momu-m/HydroMate-ESP32/3_Schaltplan_und_Diagramme/Diagramm1_Architektur.png

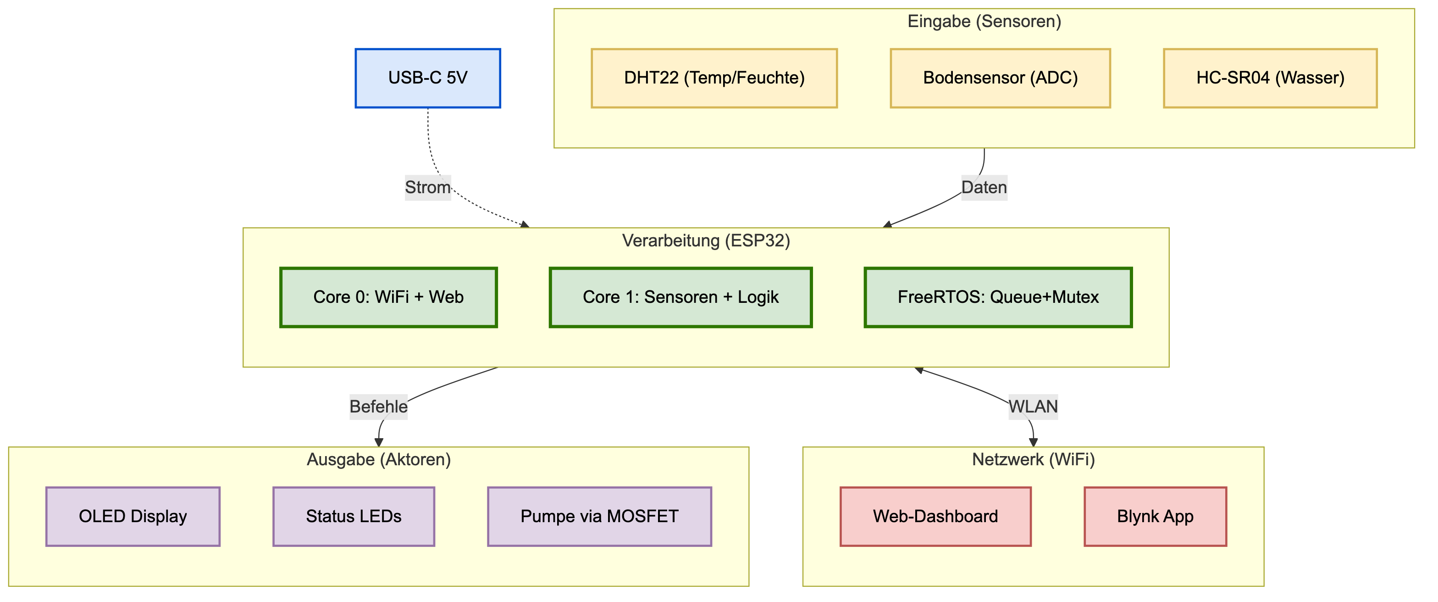
3_Schaltplan_und_Diagramme/Diagramm1_Architektur.png
