momu-m/HydroMate-ESP32/3_Schaltplan_und_Diagramme/Diagramm2_Schaltung.png

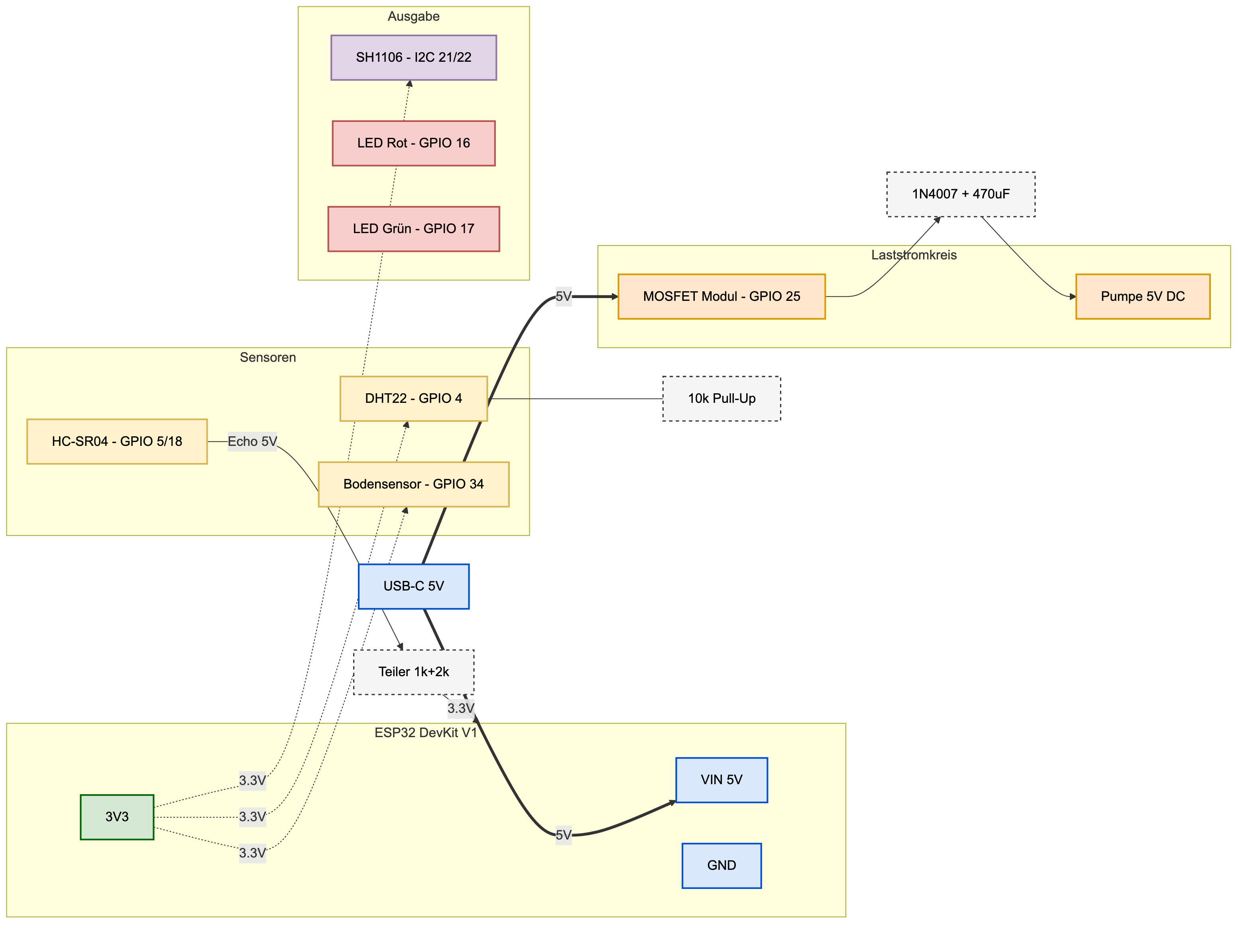
3_Schaltplan_und_Diagramme/Diagramm2_Schaltung.png
