momu-m/HydroMate-ESP32/3_Schaltplan_und_Diagramme/Diagramm3_FreeRTOS.png

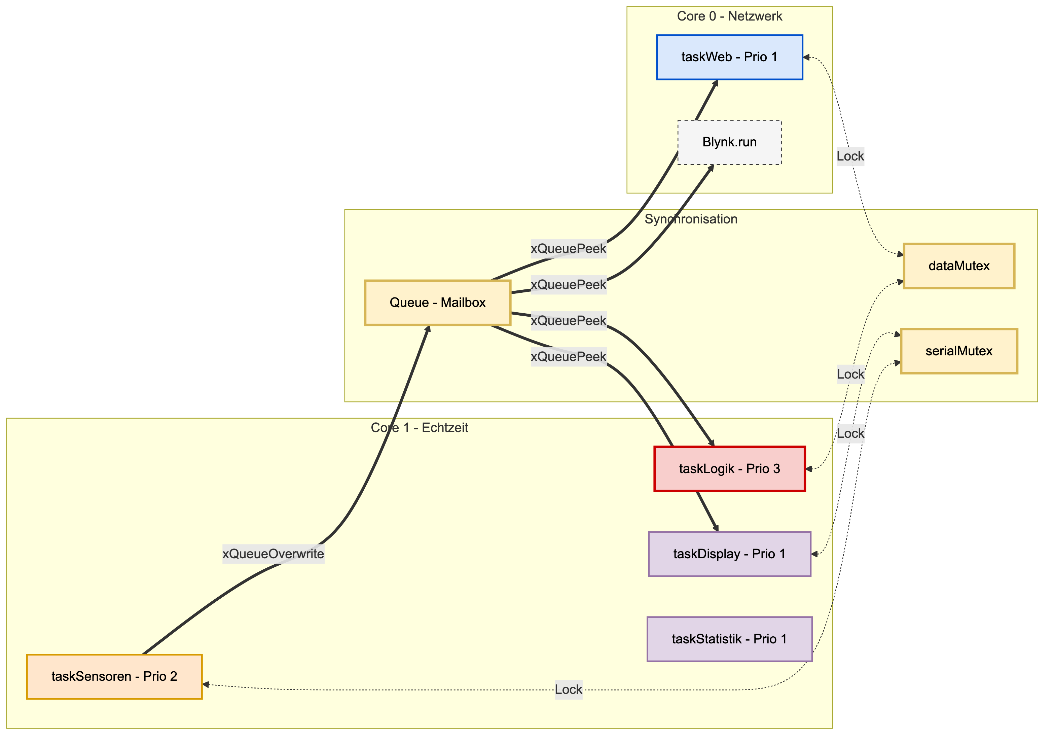
3_Schaltplan_und_Diagramme/Diagramm3_FreeRTOS.png
