momu-m/HydroMate-ESP32/3_Schaltplan_und_Diagramme/Diagramm4_MooreAutomat.png

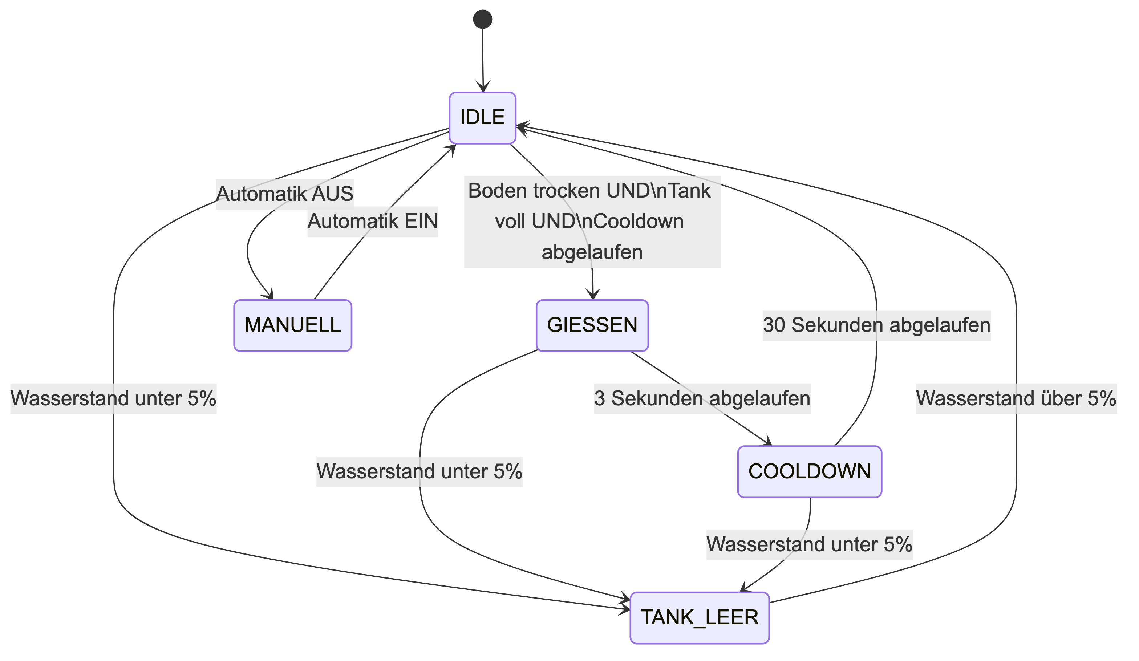
3_Schaltplan_und_Diagramme/Diagramm4_MooreAutomat.png
