momu-m/HydroMate-ESP32/3_Schaltplan_und_Diagramme/Diagramm_1_Systemarchitektur_KORRIGIERT_pro.png

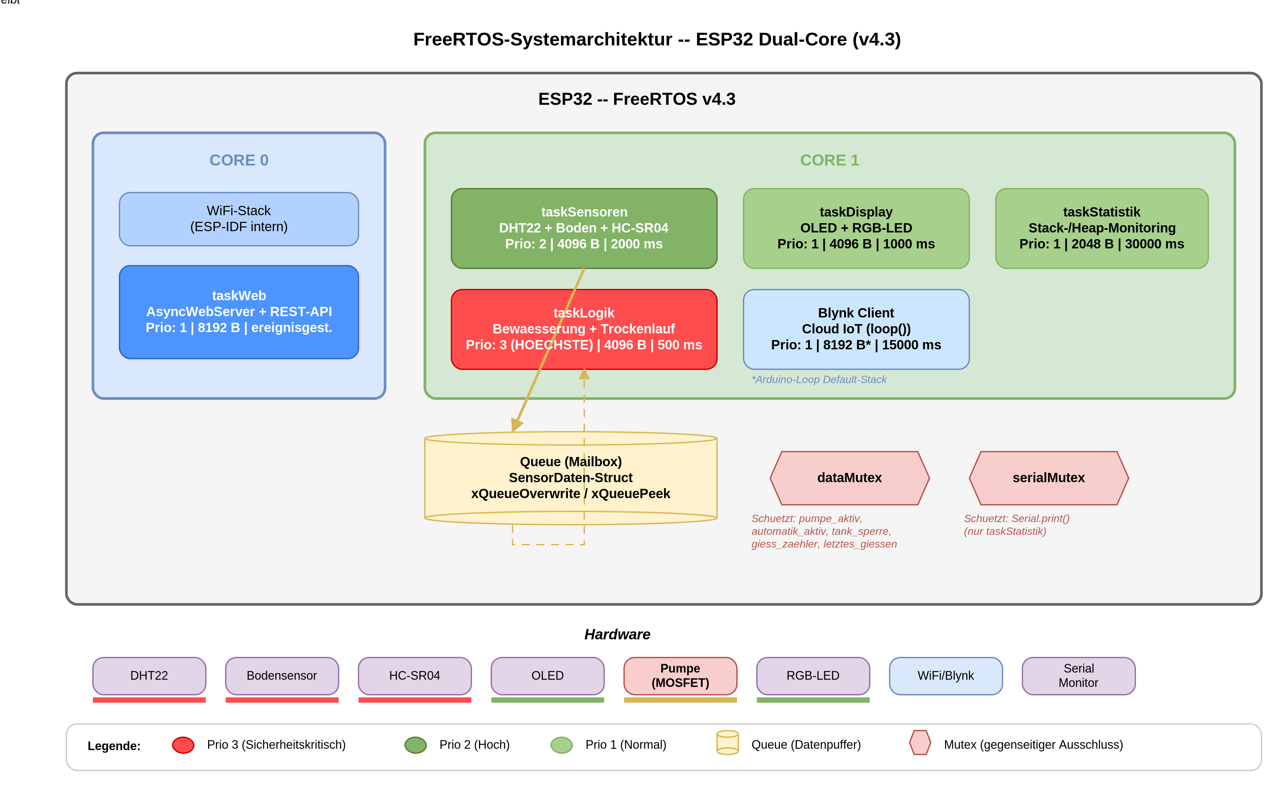
3_Schaltplan_und_Diagramme/Diagramm_1_Systemarchitektur_KORRIGIERT_pro.png
