momu-m/HydroMate-ESP32/3_Schaltplan_und_Diagramme/SCH_Schematic1_1-P1_2026-03-08.png

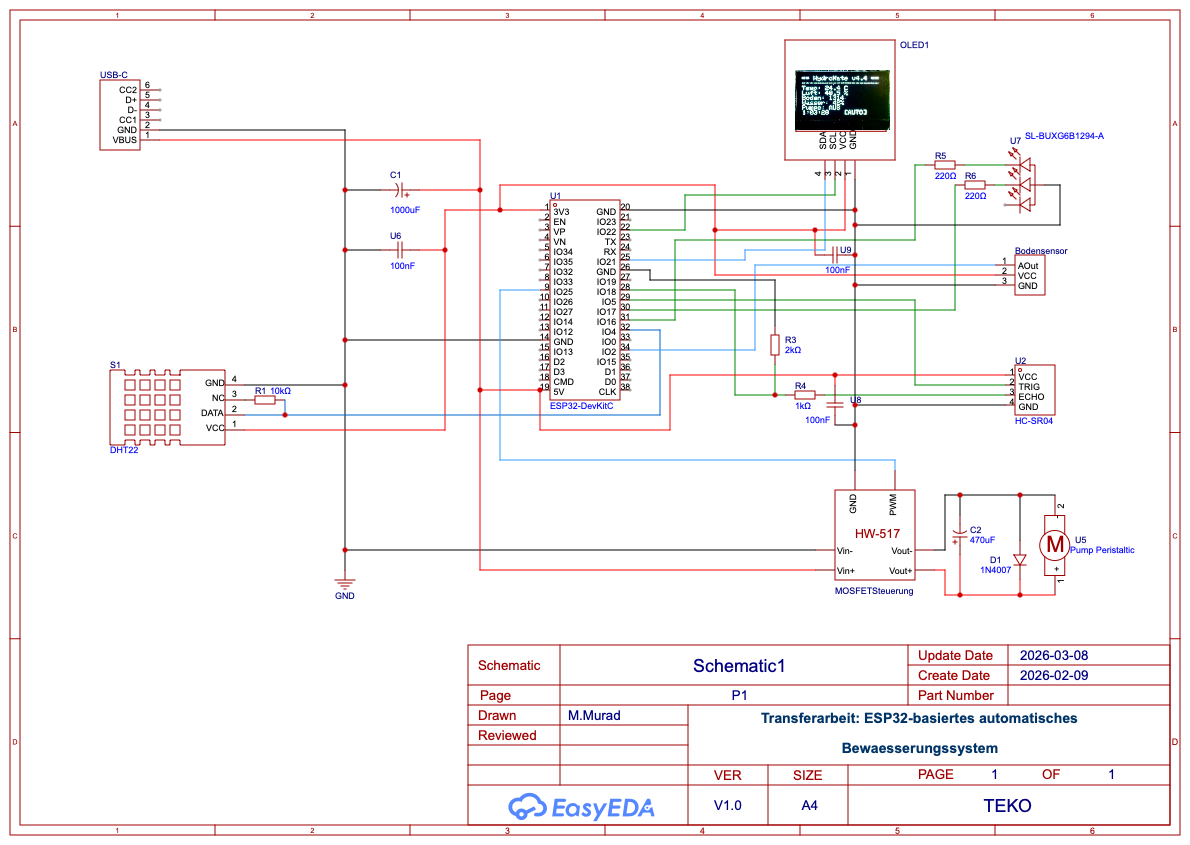
3_Schaltplan_und_Diagramme/SCH_Schematic1_1-P1_2026-03-08.png
