momu-m/HydroMate-ESP32/3_Schaltplan_und_Diagramme/SCH_Schematic1_2026-03-09.pdf

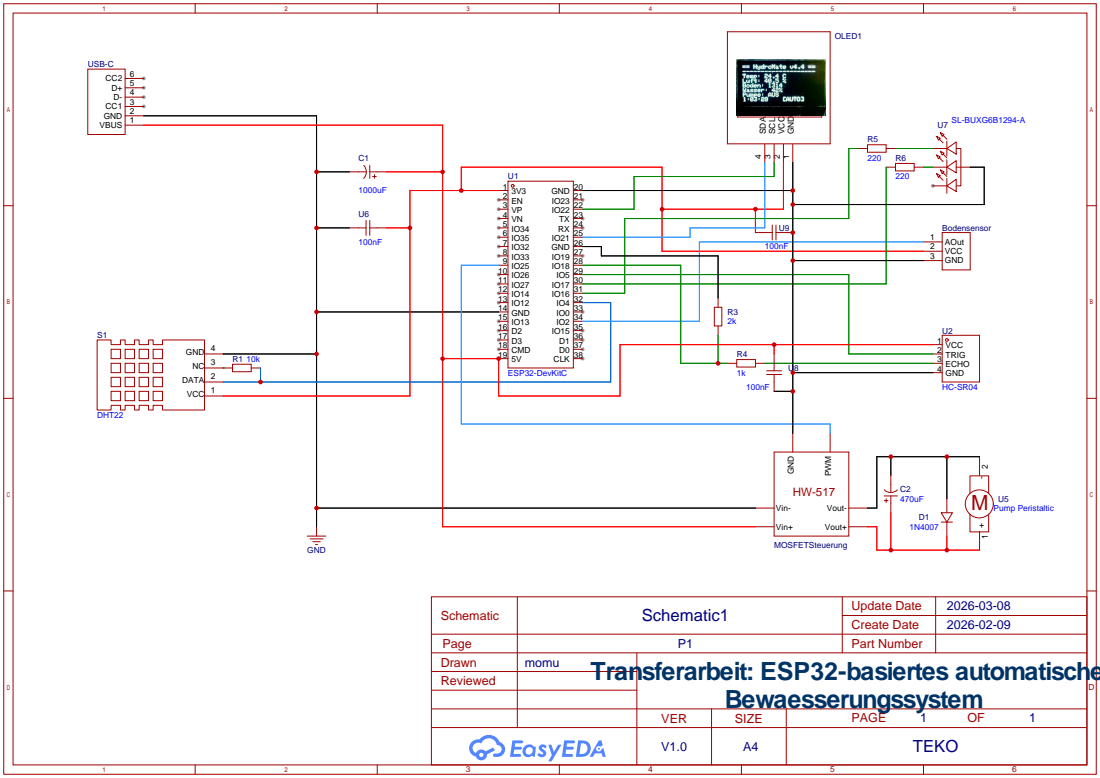
[picture p8: page 1]
