momu-m/HydroMate-ESP32/(commit log)

2026-03-09 HydroMate v4.4 - ESP32 Bewaesserungssystem mit FreeRTOS
    - 6 FreeRTOS Tasks auf Dual-Core ESP32
    - 3 Sensoren (DHT22, Bodensensor, HC-SR04)
    - 3 Benutzerschnittstellen (OLED, Web, Blynk)
    - Moore-Automat mit 5 Zustaenden
    - Trockenlauf-Schutz
    - 994 Zeilen Code, vollstaendig kommentiert
2026-03-09 Schaltplan (EasyEDA PDF) und aktualisierten Quellcode hinzugefuegt
